jmacarthur/zeta256/kicad/z80switch.sch

## KiCad design kicad/z80switch.sch (2016-03-15)

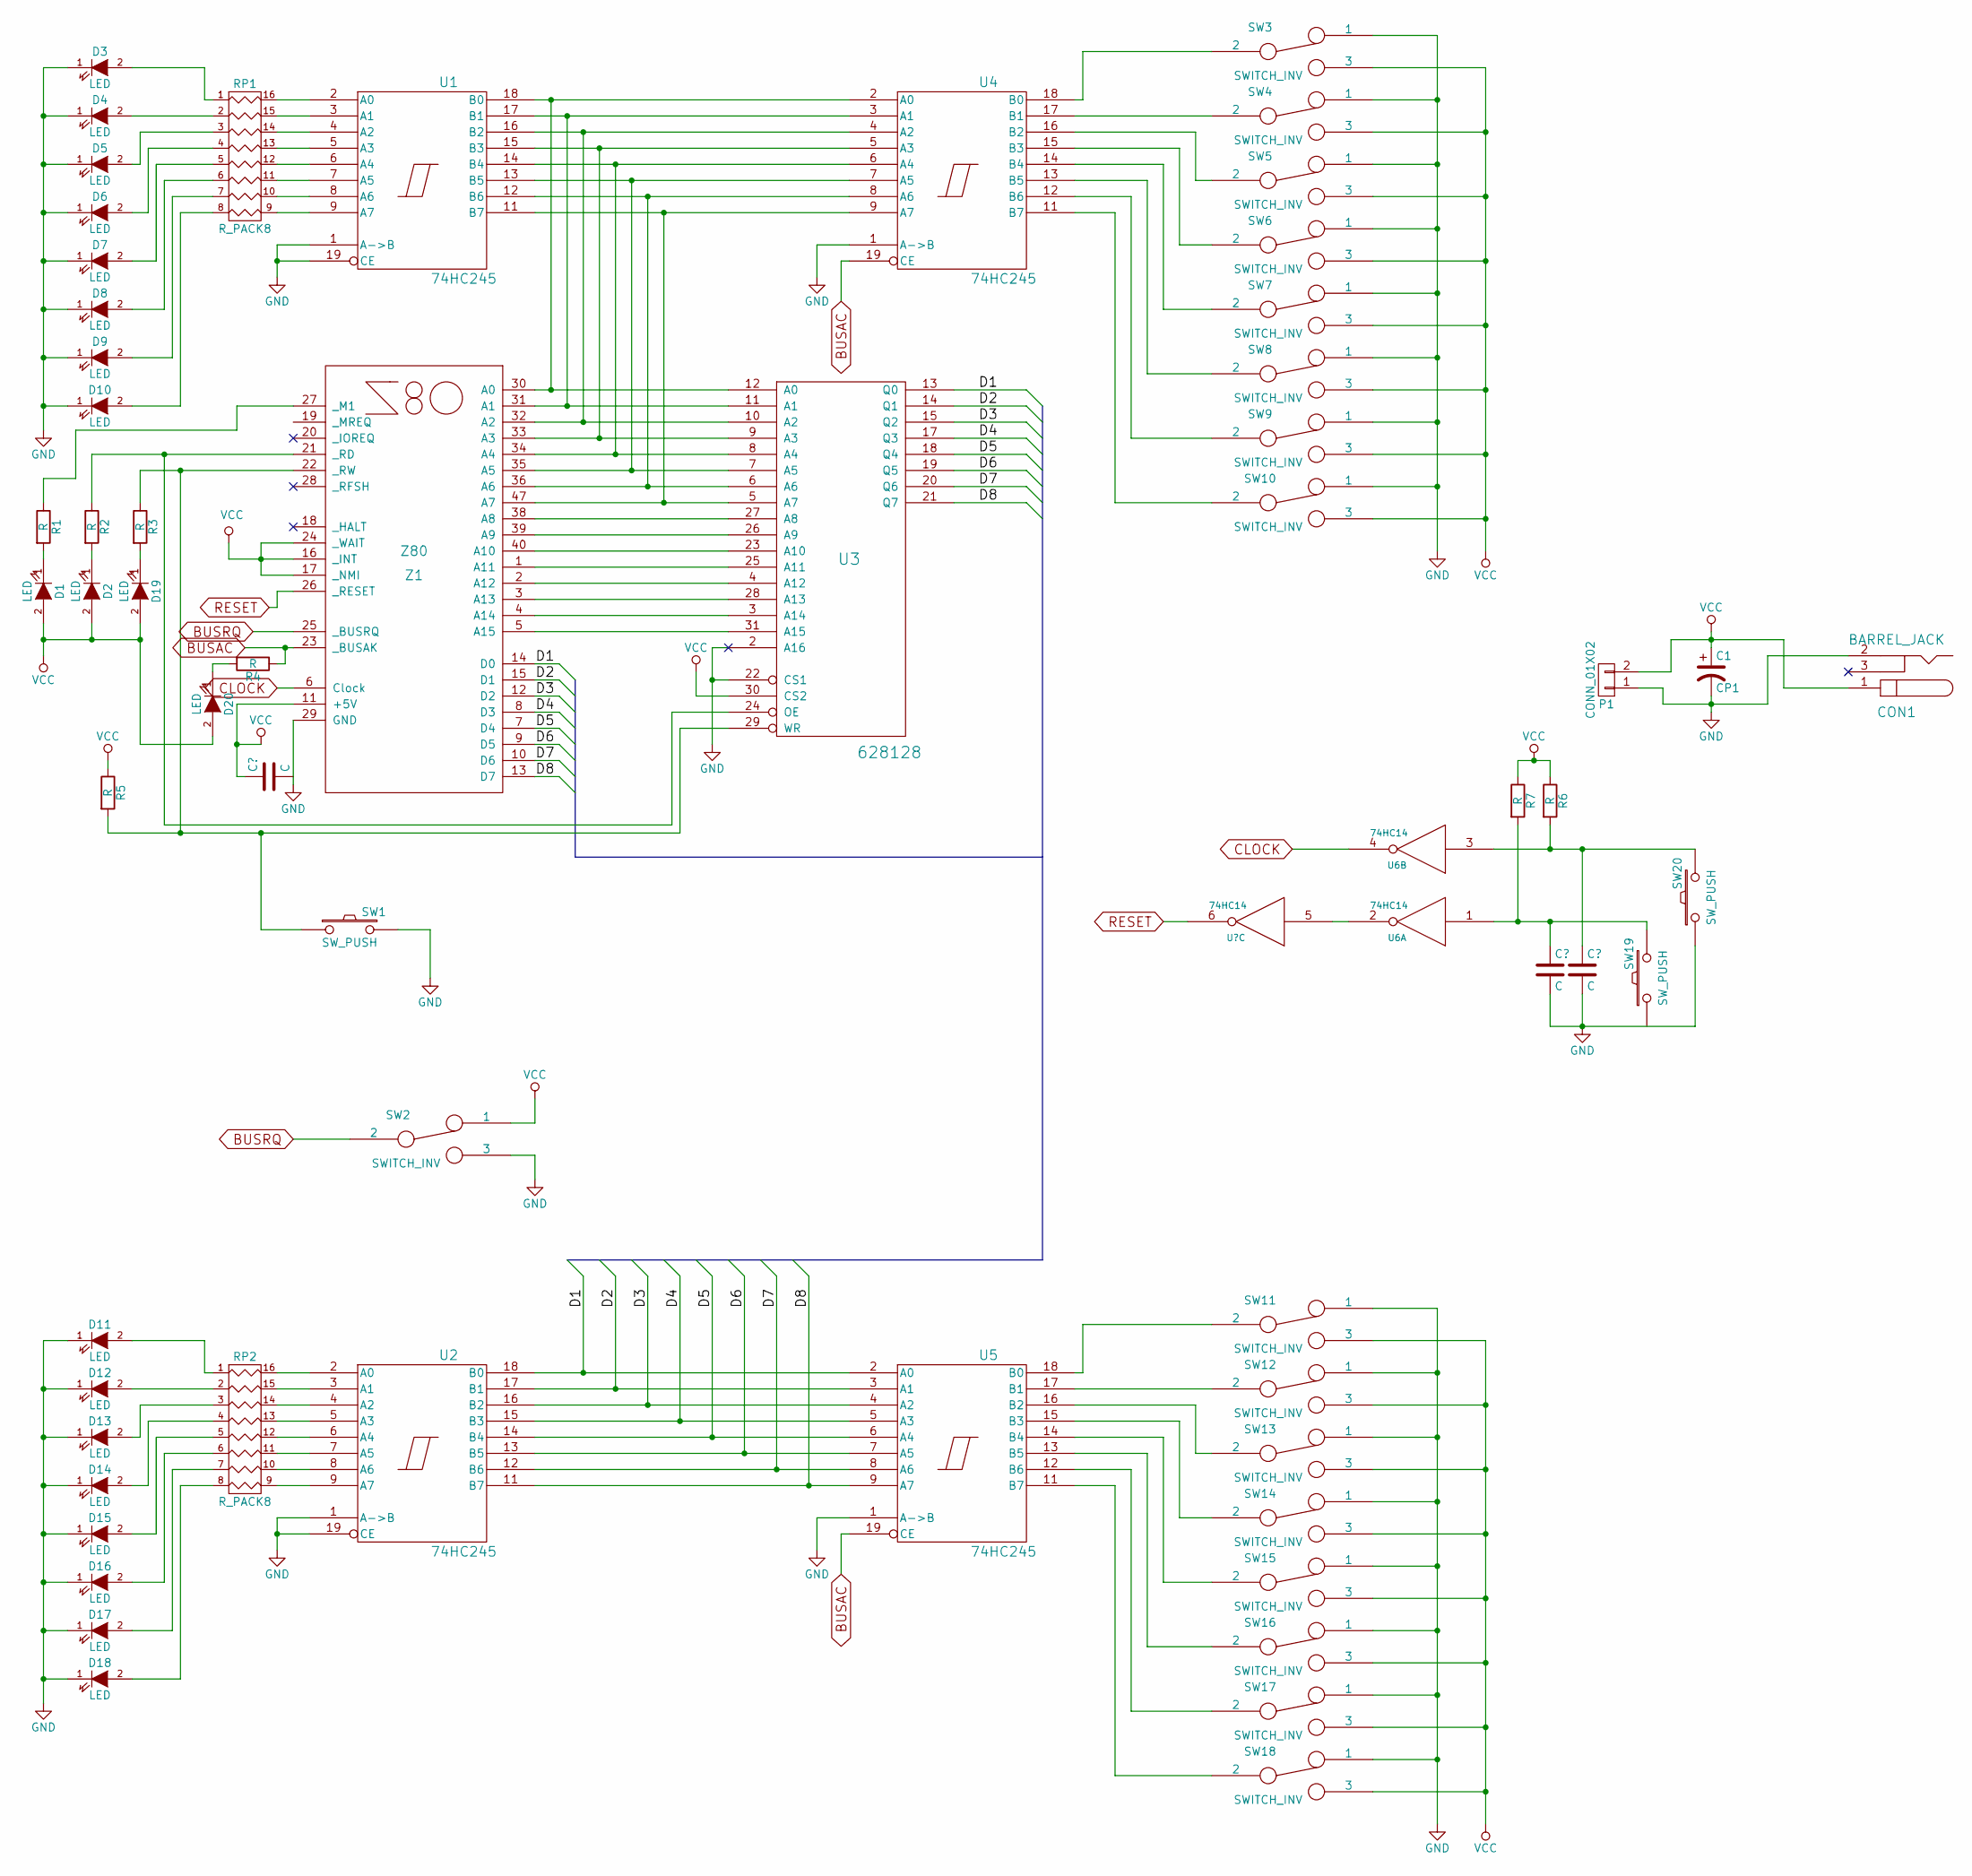
[picture p4: schematic z80switch.sch]

Parts:
C1: CP1
CON1: BARREL_JACK
D1, D2, D3, D4, D5, D6, D7, D8, D9, D10, D11, D12, D13, D14, D15, D16, D17, D18, D19, D20: LED
P1: CONN_01X02
R1, R2, R3, R4, R5, R6, R7: R
RP1, RP2: R_PACK8
SW1, SW19, SW20: SW_PUSH
SW2, SW3, SW4, SW5, SW6, SW7, SW8, SW9, SW10, SW11, SW12, SW13, SW14, SW15, SW16, SW17, SW18: SWITCH_INV
U1, U2, U4, U5: 74HC245
U3: 628128
U6: 74HC14
Z1: Z80

Connections:
BUSAC: R4.1, U4.19 (CE), U5.19 (CE), Z1.23 (_BUSAK)
BUSRQ: SW2.2, Z1.25 (_BUSRQ)
CLOCK: U6.4, Z1.6 (Clock)
D1: U2.18 (B0), U3.13 (Q0), U5.2 (A0), Z1.14 (D0)
D2: U2.17 (B1), U3.14 (Q1), U5.3 (A1), Z1.15 (D1)
D3: U2.16 (B2), U3.15 (Q2), U5.4 (A2), Z1.12 (D2)
D4: U2.15 (B3), U3.17 (Q3), U5.5 (A3), Z1.8 (D3)
D5: U2.14 (B4), U3.18 (Q4), U5.6 (A4), Z1.7 (D4)
D6: U2.13 (B5), U3.19 (Q5), U5.7 (A5), Z1.9 (D5)
D7: U2.12 (B6), U3.20 (Q6), U5.8 (A6), Z1.10 (D6)
D8: U2.11 (B7), U3.21 (Q7), U5.9 (A7), Z1.13 (D7)
GND: C1.2, CON1.2, D3.1 (K), D4.1 (K), D5.1 (K), D6.1 (K), D7.1 (K), D8.1 (K), D9.1 (K), D10.1 (K), D11.1 (K), D12.1 (K), D13.1 (K), D14.1 (K), D15.1 (K), D16.1 (K), D17.1 (K), D18.1 (K), P1.1, SW1.2, SW2.3, SW3.1, SW4.1, SW5.1, SW6.1, SW7.1, SW8.1, SW9.1, SW10.1, SW11.1, SW12.1, SW13.1, SW14.1, SW15.1, SW16.1, SW17.1, SW18.1, SW20.1, U1.1 (A->B), U1.19 (CE), U2.1 (A->B), U2.19 (CE), U3.2 (A16), U3.22 (CS1), U4.1 (A->B), U5.1 (A->B), Z1.29 (GND)
unnamed: D1.1 (K), R1.2
unnamed: D2.1 (K), R2.2
unnamed: D3.2 (A), RP1.1
unnamed: D4.2 (A), RP1.2
unnamed: D5.2 (A), RP1.3
unnamed: D6.2 (A), RP1.4
unnamed: D7.2 (A), RP1.5
unnamed: D8.2 (A), RP1.6
unnamed: D9.2 (A), RP1.7
unnamed: D10.2 (A), RP1.8
unnamed: D11.2 (A), RP2.1
unnamed: D12.2 (A), RP2.2
unnamed: D13.2 (A), RP2.3
unnamed: D14.2 (A), RP2.4
unnamed: D15.2 (A), RP2.5
unnamed: D16.2 (A), RP2.6
unnamed: D17.2 (A), RP2.7
unnamed: D18.2 (A), RP2.8
unnamed: D19.1 (K), R3.2
unnamed: D20.1 (K), R4.2
unnamed: R1.1, Z1.27 (_M1)
unnamed: R2.1, U3.24 (OE), Z1.21 (_RD)
unnamed: R3.1, R5.2, SW1.1, U3.29 (WR), Z1.22 (_RW)
unnamed: R6.2, SW20.2, U6.3
unnamed: R7.2, SW19.2, U6.1
unnamed: RP1.9 (R8), U1.9 (A7)
unnamed: RP1.10 (R7), U1.8 (A6)
unnamed: RP1.11 (R6), U1.7 (A5)
unnamed: RP1.12 (R5), U1.6 (A4)
unnamed: RP1.13 (R4), U1.5 (A3)
unnamed: RP1.14 (R3), U1.4 (A2)
unnamed: RP1.15 (R2), U1.3 (A1)
unnamed: RP1.16 (R1), U1.2 (A0)
unnamed: RP2.9 (R8), U2.9 (A7)
unnamed: RP2.10 (R7), U2.8 (A6)
unnamed: RP2.11 (R6), U2.7 (A5)
unnamed: RP2.12 (R5), U2.6 (A4)
unnamed: RP2.13 (R4), U2.5 (A3)
unnamed: RP2.14 (R3), U2.4 (A2)
unnamed: RP2.15 (R2), U2.3 (A1)
unnamed: RP2.16 (R1), U2.2 (A0)
unnamed: SW3.2, U4.18 (B0)
unnamed: SW4.2, U4.17 (B1)
unnamed: SW5.2, U4.16 (B2)
unnamed: SW6.2, U4.15 (B3)
unnamed: SW7.2, U4.14 (B4)
unnamed: SW8.2, U4.13 (B5)
unnamed: SW9.2, U4.12 (B6)
unnamed: SW10.2, U4.11 (B7)
unnamed: SW11.2, U5.18 (B0)
unnamed: SW12.2, U5.17 (B1)
unnamed: SW13.2, U5.16 (B2)
unnamed: SW14.2, U5.15 (B3)
unnamed: SW15.2, U5.14 (B4)
unnamed: SW16.2, U5.13 (B5)
unnamed: SW17.2, U5.12 (B6)
unnamed: SW18.2, U5.11 (B7)
unnamed: U1.11 (B7), U3.5 (A7), U4.9 (A7), Z1.47 (A7)
unnamed: U1.12 (B6), U3.6 (A6), U4.8 (A6), Z1.36 (A6)
unnamed: U1.13 (B5), U3.7 (A5), U4.7 (A5), Z1.35 (A5)
unnamed: U1.14 (B4), U3.8 (A4), U4.6 (A4), Z1.34 (A4)
unnamed: U1.15 (B3), U3.9 (A3), U4.5 (A3), Z1.33 (A3)
unnamed: U1.16 (B2), U3.10 (A2), U4.4 (A2), Z1.32 (A2)
unnamed: U1.17 (B1), U3.11 (A1), U4.3 (A1), Z1.31 (A1)
unnamed: U1.18 (B0), U3.12 (A0), U4.2 (A0), Z1.30 (A0)
unnamed: U3.3 (A14), Z1.4 (A14)
unnamed: U3.4 (A12), Z1.2 (A12)
unnamed: U3.23 (A10), Z1.40 (A10)
unnamed: U3.25 (A11), Z1.1 (A11)
unnamed: U3.26 (A9), Z1.39 (A9)
unnamed: U3.27 (A8), Z1.38 (A8)
unnamed: U3.28 (A13), Z1.3 (A13)
unnamed: U3.31 (A15), Z1.5 (A15)
RESET: Z1.26 (_RESET)
VCC: C1.1, CON1.1, D1.2 (A), D2.2 (A), D19.2 (A), D20.2 (A), P1.2, R5.1, R6.1, R7.1, SW2.1, SW3.3, SW4.3, SW5.3, SW6.3, SW7.3, SW8.3, SW9.3, SW10.3, SW11.3, SW12.3, SW13.3, SW14.3, SW15.3, SW16.3, SW17.3, SW18.3, U3.30 (CS2), Z1.11 (+5V), Z1.16 (_INT), Z1.17 (_NMI), Z1.24 (_WAIT)
