jmacarthur/zeta256/images/assembled.jpeg

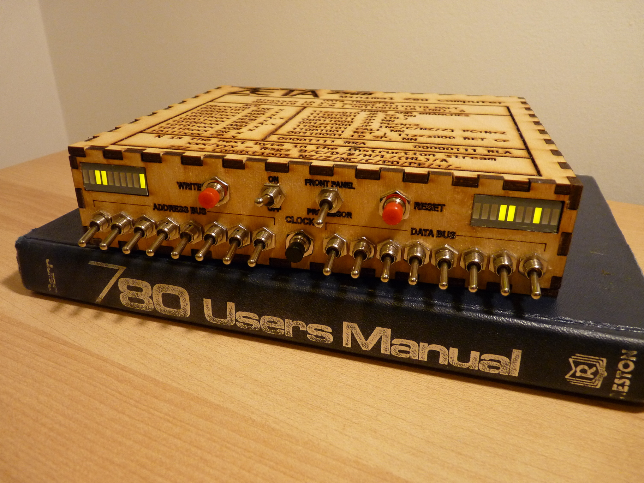
images/assembled.jpeg
