jmacarthur/zeta256/(commit log)

2014-11-10 First stage of new demo program
2014-11-11 Next stage of new demo program
2014-11-23 Add example trace from running ismulator on euclid program
2014-11-27 Add attribution for trace and shorten it
2014-11-29 Add notes about LEDs to README
2016-02-28 Initial versions of KiCad files by Samuel Doye
    [z80switch.sch]
2016-02-28 Correct read/write lines and debounced inputs
    [z80switch.sch]
2016-02-28 Add notes about KiCad project to README
2016-03-15 Tie _NMI/_INT/_WAIT to Vcc instead of ground
    [z80switch.sch]
